cemis-iceland/esp32-programmer/esp32_programmer.kicad_pcb

## KiCad design esp32_programmer.kicad_pcb (2021-05-26)

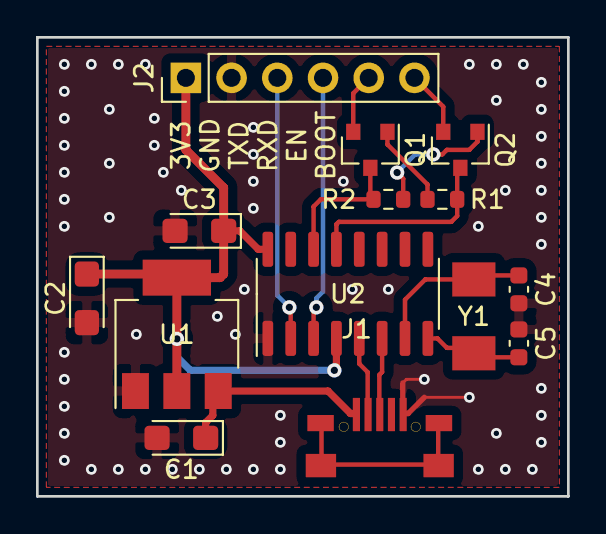
[picture p1: board esp32_programmer.kicad_pcb from above]

Board: 2 copper layers, 29.5 x 25.5 mm, 14 parts (0 on the bottom side), 15 nets.

Parts:
C1, C2, C3: 10uF; CP_EIA-3216-18_Kemet-A
C4, C5: 30pf; C_0603_1608Metric
J1: MicroQTJ; USB_MicroQTJ
J2: Conn_01x06_Male; PinHeader_1x06_P2.54mm_Vertical
Q1, Q2: Q_NPN_BCE; SOT-23
R1, R2: R; R_0603_1608Metric
U1: AMS1117-3.3; SOT-223-3_TabPin2
U2: CH340G; SOIC-16_3.9x9.9mm_P1.27mm
Y1: XSHEELNANF-12MHZ; XTAL_XSHEELNANF-12MHZ

Connections:
+3V3: C2.1, C3.1, J2.1, U1.2, U2.4, U2.16
+5VD: C1.1, J1.1, U1.3
/BOOT: J2.6, Q2.2
/DTR: Q2.3, R1.2, U2.13
/EN: J2.5, Q1.2
/RTS: Q1.3, R2.2, U2.14
/RXD: J2.4, U2.3
/TXD: J2.3, U2.2
GND: C1.2, C2.2, C3.2, C4.1, C5.2, J1.5, J2.2, U1.1, U2.1
unnamed: C4.2, U2.7, Y1.2
unnamed: C5.1, U2.8, Y1.1
unnamed: J1.2, U2.6
unnamed: J1.3, U2.5
unnamed: Q1.1, R1.1
unnamed: Q2.1, R2.1
