cemis-iceland/esp32-programmer/(threads)

Thread 3 (2021-06-14):

USB Data lines are swapped, due to incorrect USB port footprint.

cemis-iceland, 2021-06-14:
