cemis-iceland/esp32-programmer/(commit log)

2021-05-18 corrected capacitors
    [esp32_programmer.sch]
2021-05-19 Add project footprints and route PCB
    [esp32_programmer.sch]
2021-05-19 Design review: Modifications made
    Thickened power traces to 0.4mm
    Changed USB connector footrpint to comply with jlcpcb capabilities.
    [esp32_programmer.kicad_pcb]
2021-05-26 Created BOM, Gerbers and pos files. RFM.
    [BOM.csv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]
